seismicindustries/arduinoMICRACK/README.md

# arduinoMICRACK

a eurorack mountable version of the arduino micro. 

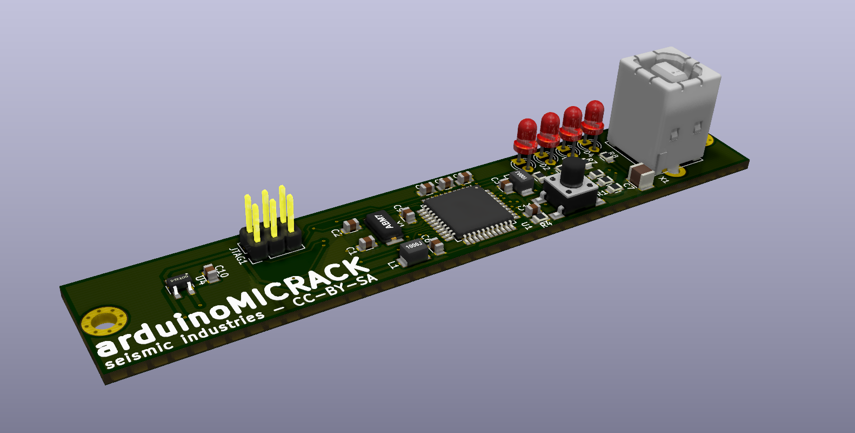
[picture p1: arduinoMICRACK_pic.png]
image of the board


by seismic industries - 2020
