seismicindustries/arduinoMICRACK/arduinoMICRACK.kicad_pcb

## KiCad design arduinoMICRACK.kicad_pcb (2020-08-17)

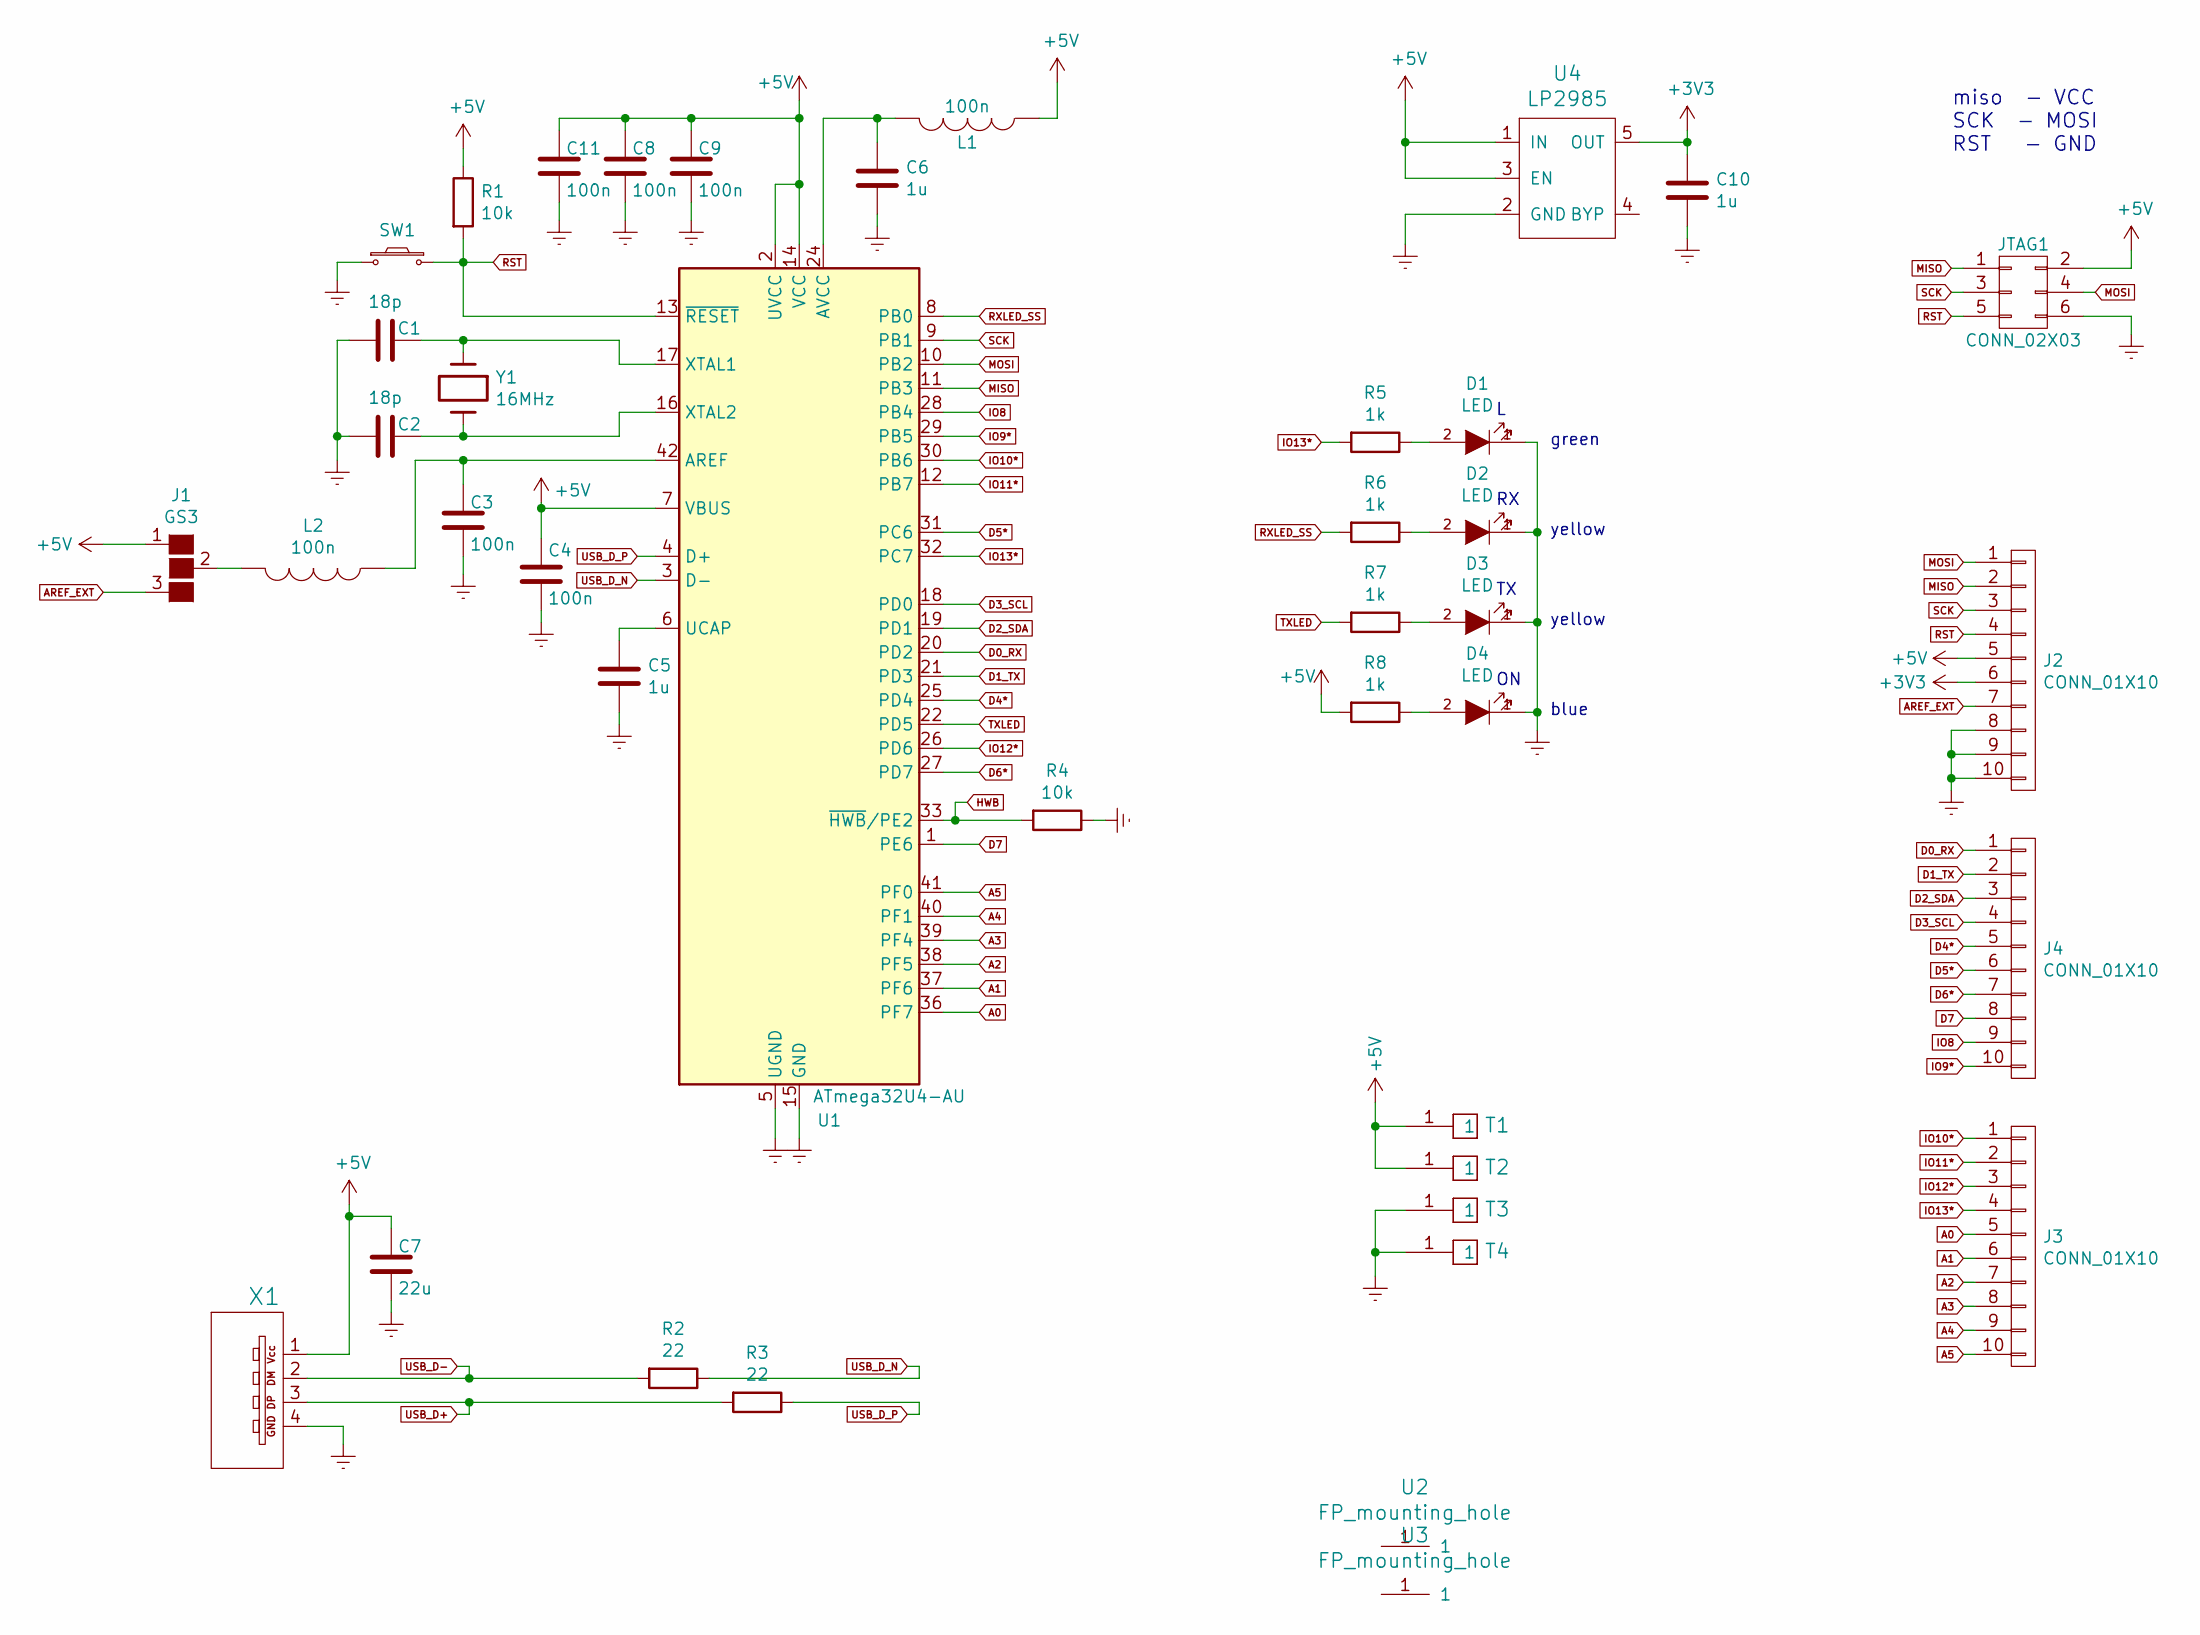
[picture p2: schematic arduinoMICRACK.sch, aruinoMICRACK]

Parts:
C1: 18p; KMS231_right_angle_switch_SMD_with_pegs; MPN VJ0805A180KXACBC
C2: 18p; C_0805; MPN VJ0805A180KXACBC
C3, C4, C8, C9, C11: 100n; C_0805; MPN 08055C104KAT2A
C5, C6, C10: 1u; C_0805; MPN UMK212B7105KG-T
C7: 22u; C_1210; MPN TMK325BJ226MM-P
D1, D2, D3, D4: LED; LED_D3.0mm; MPN LTL-4231N
J1: GS3; solderbridge
J2, J3, J4: CONN_01X10; Pin_Header_Straight_1x10_Pitch2.54mm_SMD
JTAG1: CONN_02X03; Pin_Header_Straight_2x03_Pitch2.54mm
L1, L2: 100n; Inductor_PSU_NLCV32T; MPN NLCV32T-R10M-PFR
R1, R4: 10k; R_0805; MPN CRCW080510K0FKEAC
R2, R3: 22; R_0805; MPN CRCW080522R0FKEA
R5, R6, R7, R8: 1k; R_0805; MPN CRCW08051K00FKEAC
SW1: SW_PUSH_SMALL_H; APEM_tactile_SMD_switch_6mm; MPN ADTSM66NV
T1, T2, T3, T4: TESTPIN; TESTPAD_SMD
U1: ATmega32U4-AU; TQFP-44_10x10mm_Pitch0.8mm; MPN ATMEGA32U4-AU
U2, U3: FP_mounting_hole; VIA_M3_mounting_hole
U4: LP2985; SOT-23-5; MPN LP2985-33DBVR
X1: Type B vertical; USB_TYPE_B_MUSB_Straight; MPN SS-52300-002
Y1: 16MHz; ABM7; MPN ABM7-16.000MHZ-D2Y-T

Connections:
+3V3: C10.2, J2.6, U4.5 (OUT)
+5V: C4.2, C7.2, C8.2, C9.2, C11.2, J1.1 (G1), J2.5, JTAG1.2, L1.1, R1.1, R8.2, T1.1, T2.1, U1.2 (UVCC), U1.7 (VBUS), U1.14 (VCC), U1.34 (VCC), U4.1 (IN), U4.3 (EN), X1.1
A0: J3.5, U1.36 (PF7)
A1: J3.6, U1.37 (PF6)
A2: J3.7, U1.38 (PF5)
A3: J3.8, U1.39 (PF4)
A4: J3.9, U1.40 (PF1)
A5: J3.10, U1.41 (PF0)
AREF_EXT: J1.3 (G3), J2.7
D0_RX: J4.1, U1.20 (PD2)
D1_TX: J4.2, U1.21 (PD3)
D2_SDA: J4.3, U1.19 (PD1)
D3_SCL: J4.4, U1.18 (PD0)
D4*: J4.5, U1.25 (PD4)
D5*: J4.6, U1.31 (PC6)
D6*: J4.7, U1.27 (PD7)
D7: J4.8, U1.1 (PE6)
Earth: C1.2, C2.2, C3.1, C4.1, C5.1, C6.1, C7.1, C8.1, C9.1, C10.1, C11.1, D1.1 (K), D2.1 (K), D3.1 (K), D4.1 (K), J2.8, J2.9, J2.10, JTAG1.6, R4.1, SW1.1, T3.1, T4.1, U1.5 (UGND), U1.15 (GND), U1.23 (GND), U1.35 (GND), U1.43 (GND), U4.2 (GND), X1.4
HWB: R4.2, U1.33 (~HWB~/PE2)
IO8: J4.9, U1.28 (PB4)
IO9*: J4.10, U1.29 (PB5)
IO10*: J3.1, U1.30 (PB6)
IO11*: J3.2, U1.12 (PB7)
IO12*: J3.3, U1.26 (PD6)
IO13*: J3.4, R5.2, U1.32 (PC7)
MISO: J2.2, JTAG1.1, U1.11 (PB3)
MOSI: J2.1, JTAG1.4, U1.10 (PB2)
unnamed: C1.1, U1.17 (XTAL1), Y1.1
unnamed: C2.1, U1.16 (XTAL2), Y1.2
unnamed: C3.2, L2.1, U1.42 (AREF)
unnamed: C5.2, U1.6 (UCAP)
unnamed: C6.2, L1.2, U1.24 (AVCC), U1.44 (AVCC)
unnamed: D1.2 (A), R5.1
unnamed: D2.2 (A), R6.1
unnamed: D3.2 (A), R7.1
unnamed: D4.2 (A), R8.1
unnamed: J1.2 (G2), L2.2
RST: J2.4, JTAG1.5, R1.2, SW1.2, U1.13 (~RESET)
RXLED_SS: R6.2, U1.8 (PB0)
SCK: J2.3, JTAG1.3, U1.9 (PB1)
TXLED: R7.2, U1.22 (PD5)
USB_D+: R3.2, X1.3
USB_D-: R2.2, X1.2
USB_D_N: R2.1, U1.3 (D-)
USB_D_P: R3.1, U1.4 (D+)

Notes on the sheet:
miso - VCC SCK - MOSI RST - GND
green
yellow
blue

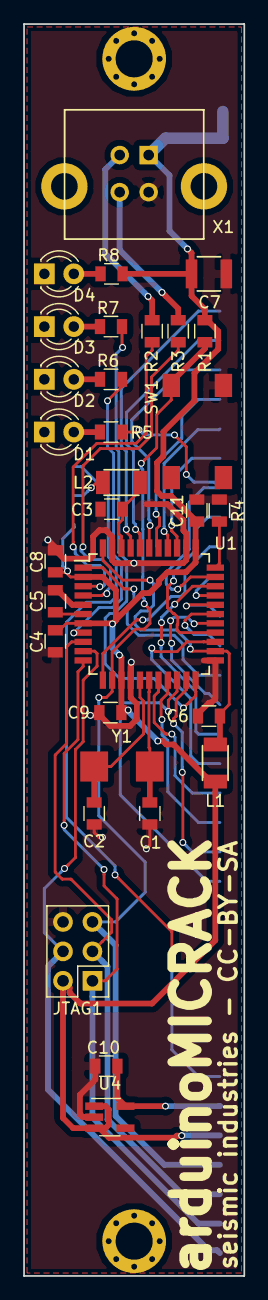
[picture p3: board arduinoMICRACK.kicad_pcb from above]

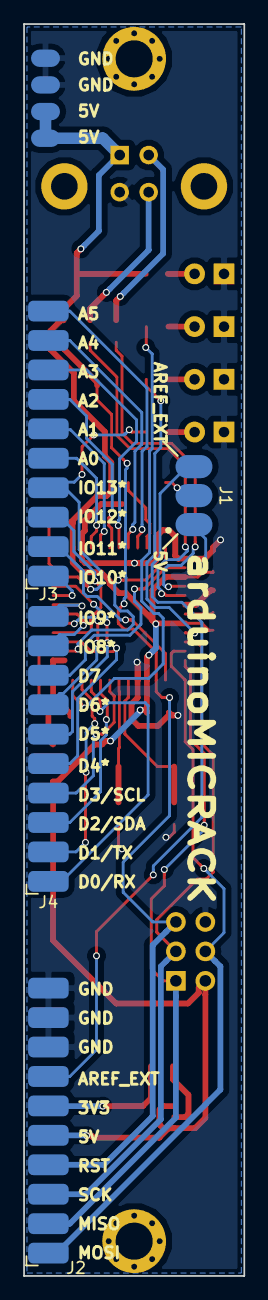
[picture p4: board arduinoMICRACK.kicad_pcb from below]

Board: 2 copper layers, 19.0 x 108.0 mm, 41 parts (8 on the bottom side), 45 nets.
