seismicindustries/arduinoMICRACK/(notices)

Notices in the files:
arduinoMICRACK.kicad_pcb:
seismic industries - CC-BY-SA
